Traiserdinger/Cubli-Version-2/(list of files, drawings)

Other design files:
hardware/Connector.SchDoc
hardware/CubliV2.PrjPcb
hardware/CubliV2PCB.PcbDoc
hardware/MCU.SchDoc
hardware/Power.SchDoc
