Traiserdinger/Cubli-Version-2/(commit log)

2026-11-12 Initial commit: CubliV2 hardware (Altium), manufacturing files and docs
    [Connector.SchDoc, CubliV2.PrjPcb, CubliV2.xlsx, CubliV2PCB.PcbDoc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]
2026-11-12 docs: record owner answers in context.md
    - IMU PCB identity and UART protocol (read from its firmware source)
    - J7 powers the IMU PCB
    - R15 fitted as 0.05 ohm: INA219 configuration recomputed
    - motor model 24H404J110 (12 V) and RemRC reference behaviour
    - section 11 turned into decisions + remaining open questions
    Claude-Session: https://claude.ai/code/session_01XEKJ4xSdt6ohMNAffENcQC
2026-11-13 firmware: hardware-independent core, control and logic libraries with tests
    - core: vector/quaternion math, CRC-8/CRC-16, SPSC ring, seqlock, filters
    - estimation: IMU PCB frame v1/v2 parser, wheel speed, INA219 arithmetic
    - control: per-axis reaction-wheel model, discrete LQR (doubling algorithm),
    edge/vertex balance controller with back-EMF compensation and
    equilibrium self-trim, least-squares system identification
    - logic: parameter table (NVS blob), calibration data, motor-axis
    calibration, supervisor state machine, CLI tokenizer
    - board_pins.h generated from context.md section 4 with static checks
    - 28 native tests incl. closed-loop simulation of edge and vertex balance
    Co-Author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
2026-11-13 firmware: ESP-IDF application (drivers, tasks, CLI, BLE)
    - safe motor init order (BRAKE low, PWM high, LEDC 100 % duty)
    - PCNT encoders, INA219, IMU PCB UART link with baud search and v2 upgrade
    - 1 kHz control task on core 1 paced by IMU frames, deadman timer, TWDT
    - power, UI (LED, buzzer, BOOT button), console and telemetry tasks
    - USB + BLE (Nordic UART Service) command line: bench, wiretest, params,
    calibration, arm/disarm, autotune, sysid, LQR, log, telemetry
    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
    [partitions.csv]
2026-11-13 firmware docs, tools and IMU PCB frame v2 patch
    - firmware/README.md: build, architecture, safety, bring-up order,
    commands, control design, telemetry, open points
    - tools/lqr_design.py (numpy, same algorithm as the firmware) and
    tools/plot_telemetry.py
    - imu_pcb/: frame v2 (quaternion + bias-corrected gyro + accel, CRC-16)
    for the STM32 IMU PCB firmware, commands CUBLI/FRAME1/REINIT; original
    and patched files plus unified diff
    - context.md: firmware status and frame v2 definition
    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
    [app_config.h, app_main.c, comm_protocol.c, comm_protocol.h, lqr_design.py, plot_telemetry.py]
2026-11-13 firmware: wiretest brake phase commands PWM with BRAKE engaged
    Before, the output stage forced every PWM to stop whenever BRAKE was low,
    so the brake check could never fail.
    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
    [control_task.cpp]
2026-11-13 docs: author name, PCB top view and schematic sheet images
    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
